faisal-shah/prayer-room-bracket/output/ceiling_rod_hook.step

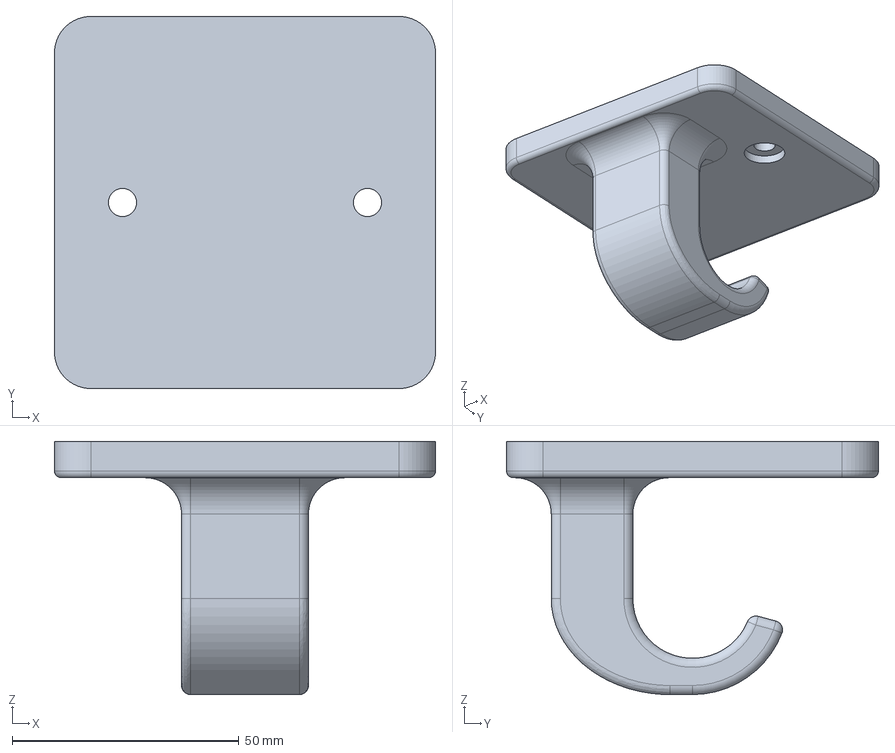
[picture p11: CAD file, 2026-11-05]
output/ceiling_rod_hook.step
84.0 x 82.0 x 55.8 mm
