faisal-shah/prayer-room-bracket/(list of files, cad)

Other CAD files:
output/ceiling_rod_hook.3mf
output/ceiling_rod_hook.stl
