faisal-shah/prayer-room-bracket/(commit log)

2026-11-04 Add ceiling rod hook model, docs and outputs
    [ceiling_rod_hook.3mf, ceiling_rod_hook.step, ceiling_rod_hook.stl]
2026-11-05 fix(hook): deepen stem after layer-split failure
    The printed hook (8 mm stem, 24 mm wide, R5 root fillet, thin shell
    over sparse infill) split along one layer just below the stem/cradle
    tangent. Printed plate-down, the stem's bending stress crosses the
    layers: 3.72 MPa at 4 kg, at the root fillet and at that shoulder.
    Deepen the stem to 18 mm toward the wall, tapering its outer face
    along an ellipse into the cradle while the open side keeps the 8 mm
    wall to the lip. Widen the hook to 28 mm, enlarge the root fillet to
    R8 and widen the plate to 82 mm to carry them. The hole pattern,
    cradle, lip and rod position are unchanged. Peak layer stress falls
    to 1.09 MPa and the mass rises from 63 g to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
    [ceiling_rod_hook.3mf, ceiling_rod_hook.step, ceiling_rod_hook.stl]
